milljohn/SmartSoilTemp/completed-sensor.JPG

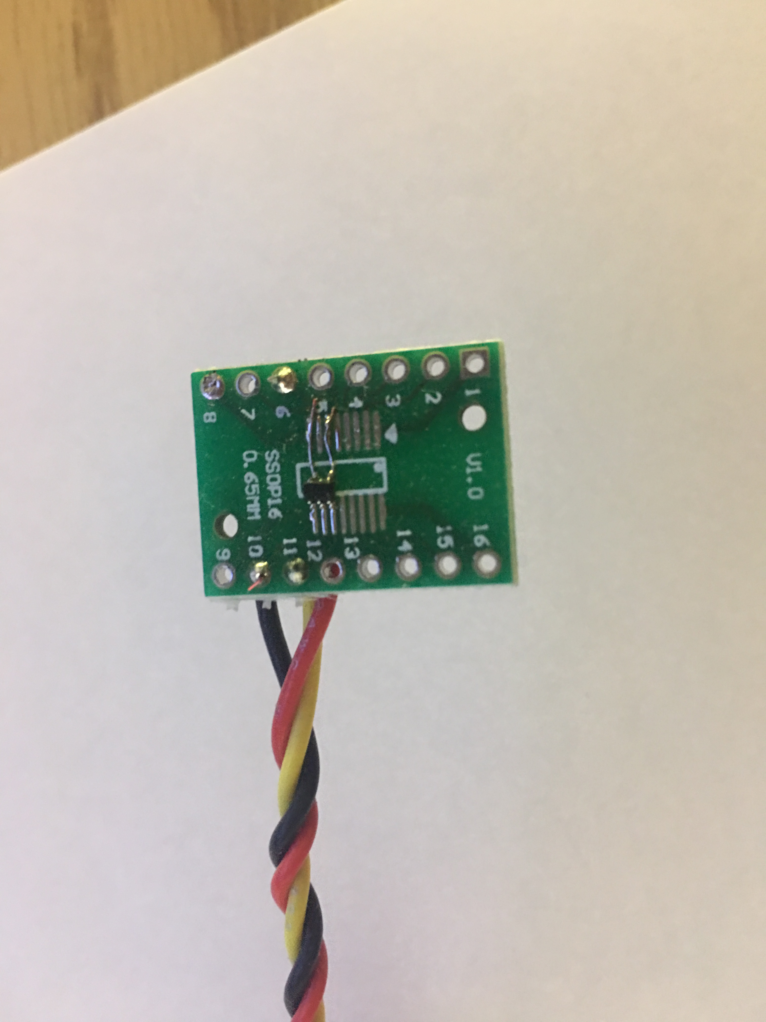
completed-sensor.JPG
