milljohn/SmartSoilTemp/completed-board.JPG

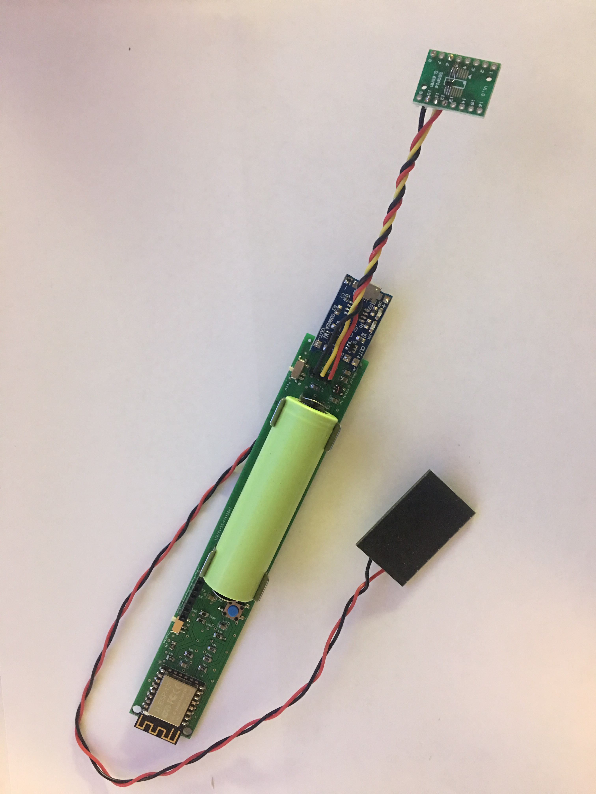
completed-board.JPG
