milljohn/SmartSoilTemp/Python Script/Daily Averages.png

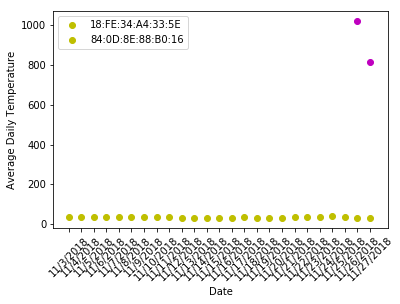
Python Script/Daily Averages.png
