milljohn/SmartSoilTemp/Python Script/DataCollector - DataLogger.csv

ID | DateTime | Tag | Value
1 | 11/3/2018 19:20:00 | 18:FE:34:A4:33:5E | 39
2 | 11/3/2018 20:17:05 | 18:FE:34:A4:33:5E | 39
3 | 11/3/2018 21:12:22 | 18:FE:34:A4:33:5E | 35
4 | 11/3/2018 22:09:21 | 18:FE:34:A4:33:5E | 34
5 | 11/3/2018 23:06:15 | 18:FE:34:A4:33:5E | 34
6 | 11/4/2018 0:03:11 | 18:FE:34:A4:33:5E | 34
7 | 11/4/2018 1:00:11 | 18:FE:34:A4:33:5E | 33
8 | 11/4/2018 1:57:03 | 18:FE:34:A4:33:5E | 33
9 | 11/4/2018 1:53:58 | 18:FE:34:A4:33:5E | 32
10 | 11/4/2018 2:50:48 | 18:FE:34:A4:33:5E | 31
11 | 11/4/2018 3:47:36 | 18:FE:34:A4:33:5E | 31
12 | 11/4/2018 4:44:39 | 18:FE:34:A4:33:5E | 31
13 | 11/4/2018 5:41:38 | 18:FE:34:A4:33:5E | 31
14 | 11/4/2018 6:38:28 | 18:FE:34:A4:33:5E | 30
15 | 11/4/2018 7:35:35 | 18:FE:34:A4:33:5E | 30
16 | 11/4/2018 8:35:11 | 18:FE:34:A4:33:5E | 38
17 | 11/4/2018 9:33:45 | 18:FE:34:A4:33:5E | 40
18 | 11/4/2018 10:31:09 | 18:FE:34:A4:33:5E | 40
19 | 11/4/2018 11:27:57 | 18:FE:34:A4:33:5E | 41
20 | 11/4/2018 12:24:54 | 18:FE:34:A4:33:5E | 40
21 | 11/4/2018 13:21:30 | 18:FE:34:A4:33:5E | 38
22 | 11/4/2018 14:18:08 | 18:FE:34:A4:33:5E | 38
23 | 11/4/2018 15:14:59 | 18:FE:34:A4:33:5E | 38
24 | 11/4/2018 16:11:55 | 18:FE:34:A4:33:5E | 37
25 | 11/4/2018 17:08:49 | 18:FE:34:A4:33:5E | 37
26 | 11/4/2018 18:05:33 | 18:FE:34:A4:33:5E | 36
27 | 11/4/2018 19:02:20 | 18:FE:34:A4:33:5E | 35
28 | 11/4/2018 19:59:11 | 18:FE:34:A4:33:5E | 35
29 | 11/4/2018 20:56:04 | 18:FE:34:A4:33:5E | 35
30 | 11/4/2018 21:52:47 | 18:FE:34:A4:33:5E | 35
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
623 | 11/27/2018 11:59:20 | 84:0D:8E:88:B0:16 | 290
624 | 11/27/2018 12:19:18 | 18:FE:34:A4:33:5E | 39
625 | 11/27/2018 12:57:15 | 84:0D:8E:88:B0:16 | 287.88
626 | 11/27/2018 13:16:14 | 18:FE:34:A4:33:5E | 38
627 | 11/27/2018 13:54:07 | 84:0D:8E:88:B0:16 | 282.75
