milljohn/SmartSoilTemp/Python Script/DataCollector - Summary.pdf

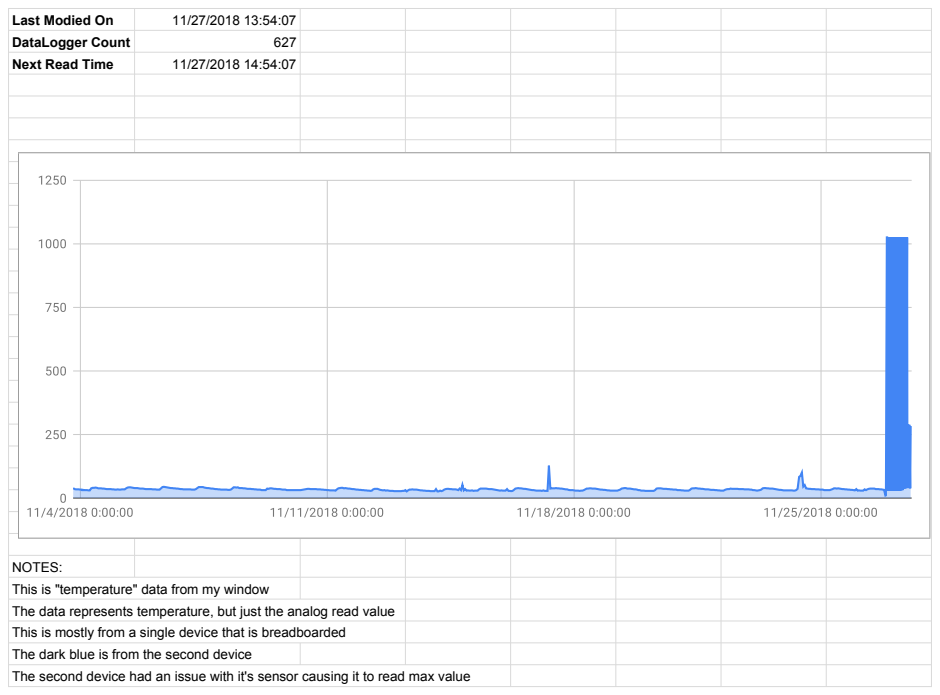
[picture p4: page 1]
Last Modied On; DataLogger Count; Next Read Time

NOTES:
This is "temperature" data from my window
The data represents temperature, but just the analog read value
This is mostly from a single device that is breadboarded
The dark blue is from the second device
The second device had an issue with it's sensor causing it to read max value
