milljohn/SmartSoilTemp/PCB and Schematics/soil temp v0.1.brd

## EAGLE design PCB and Schematics/soil temp v0.1.brd (2019-02-26)

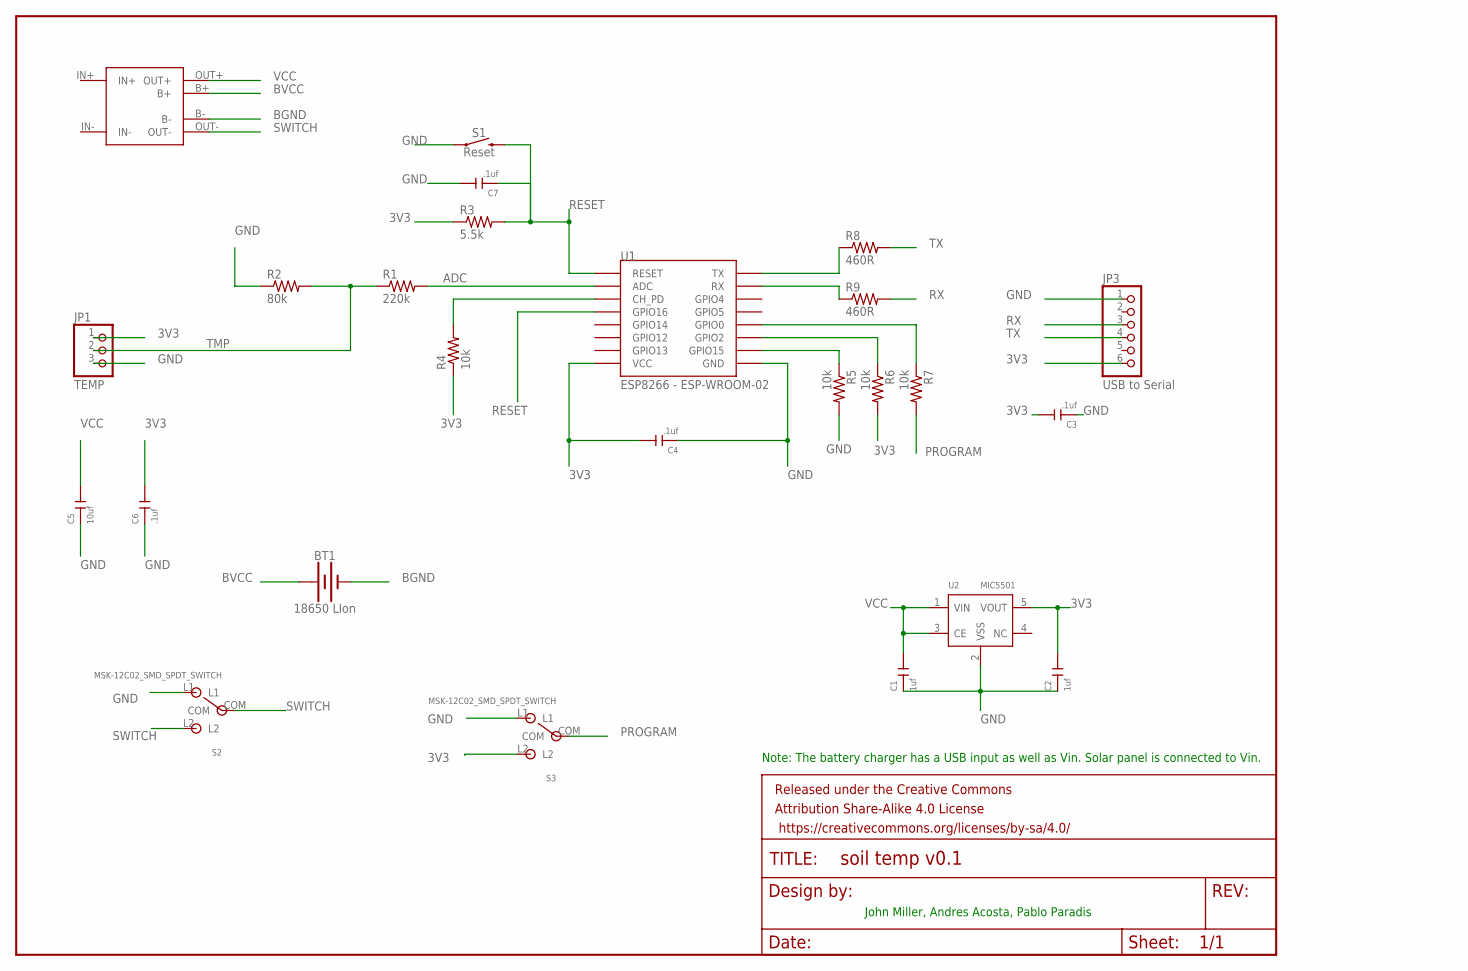
[picture p5: schematic soil temp v0.1.sch]

Parts:
BT1: 18650 LIon; BATTERY_18650-HOLDER
C1, C2: 1uf; C0805
C3, C4, C6, C7: .1uf; C0805
C5: 10uf; C0805
FRAME1: FRAME-LETTERNO_PACKAGE; DUMMY
JP1: TEMP; 1X03
JP3: USB to Serial; 1X06/90
R1: 220k; R0805
R2: 80k; R0805
R3: 5.5k; R0805
R4, R5, R6, R7: 10k; R0805
R8, R9: 460R; R0805
S1: Reset; TACTILE_SWITCH_SMD_6.2MM_TALL
S2, S3: MSK-12C02_SMD_SPDT_SWITCH; MSK-12C02
U1: ESP8266 - ESP-WROOM-02; ESP12
U2: MIC5501; SOT-23-5
U3: TP4056-MODULE; TP4056-LITHIUM-PROTECTED-MODULE

Connections:
3V3: C2.2, C3.2, C4.2, C6.2, JP1.1, JP3.6, R3.1, R4.1, R6.2, S3.L2, U1.VCC, U2.5 (VOUT)
ADC: R1.2, U1.ADC
BGND: BT1.GND@1 (-), U3.B-
BVCC: BT1.PWR@1 (+), U3.B+
GND: C1.1, C2.1, C3.1, C4.1, C5.1, C6.1, C7.2, JP1.3, JP3.1, R2.1, R5.2, S1.A2 (1), S2.L1, S3.L1, U1.GND, U2.2 (VSS)
IN+: U3.IN+
IN-: U3.IN-
unnamed: R4.2, U1.CH_PD
unnamed: R5.1, U1.GPIO15
unnamed: R6.1, U1.GPIO2
unnamed: R7.1, U1.GPIO0
PROGRAM: R7.2, S3.COM
R2RX: R9.1, U1.RX
R2TX: R8.1, U1.TX
RESET: C7.1, R3.2, S1.B2 (2), U1.GPIO16, U1.RESET
RX: JP3.3, R9.2
SWITCH: S2.COM, S2.L2, U3.OUT-
TMP: JP1.2, R1.1, R2.2
TX: JP3.4, R8.2
VCC: C1.2, C5.2, U2.1 (VIN), U2.3 (CE), U3.OUT+

Notes on the sheet:
Note: The battery charger has a USB input as well as Vin. Solar panel is connected to Vin.
John Miller, Andres Acosta, Pablo Paradis

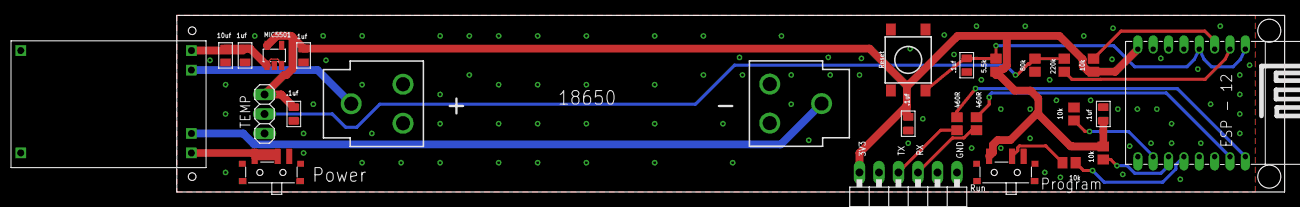
[picture p6: board soil temp v0.1.brd from above]

Board: 2 copper layers, 144.3 x 23.0 mm, 26 parts (0 on the bottom side), 18 nets.
